hedley-a/MakitaSolarCharger/docs/JBD_BMS_Diagram.pdf

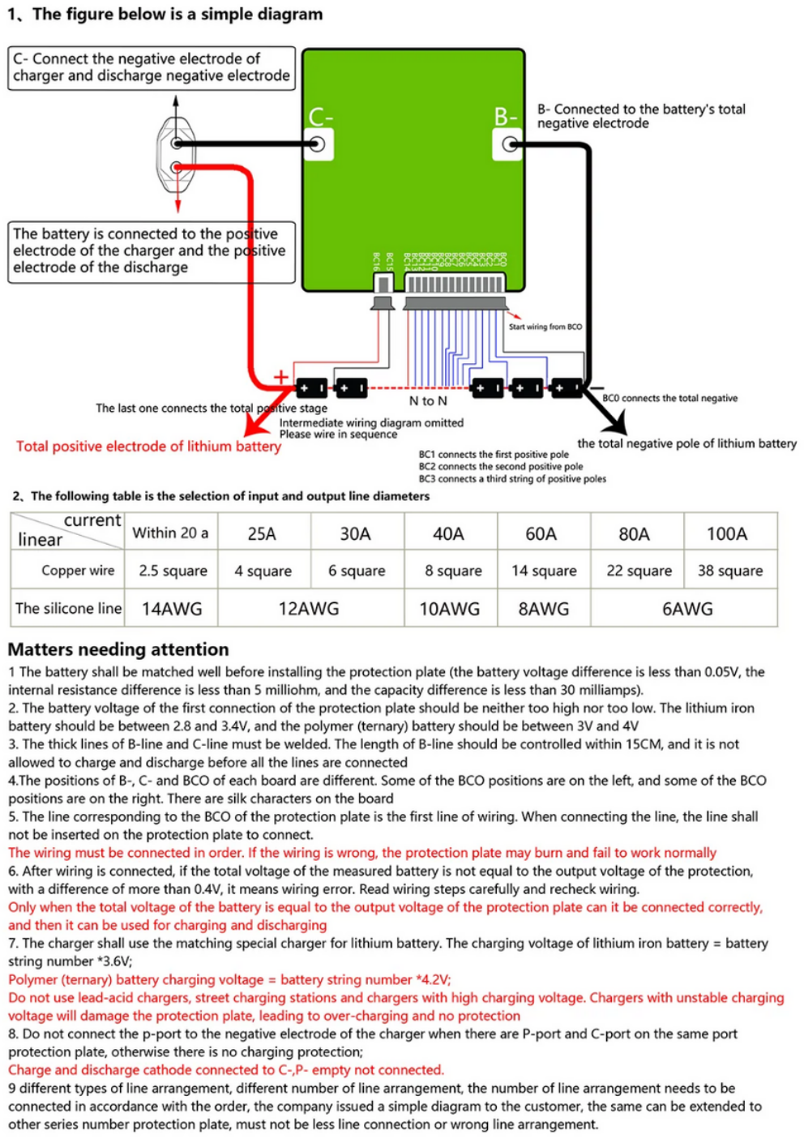
[picture p6: page 1]
