hedley-a/MakitaSolarCharger/docs/Schematic-Mower-Control.pdf

## 485-TTL

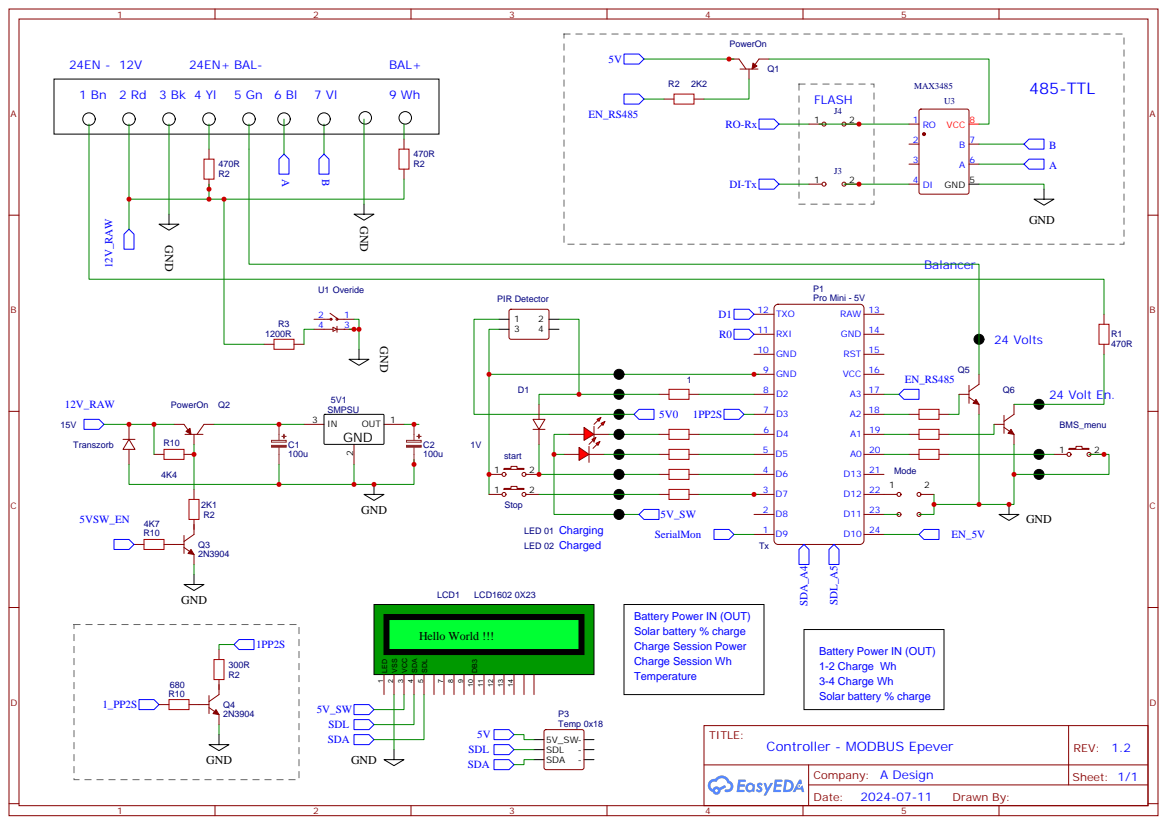
[picture p7: page 1]

Battery Power IN (OUT)
Solar battery % charge
Battery Power IN (OUT) Charge Session Power
Charge Session Wh
Temperature

## External Battery Enclosure

## Battery

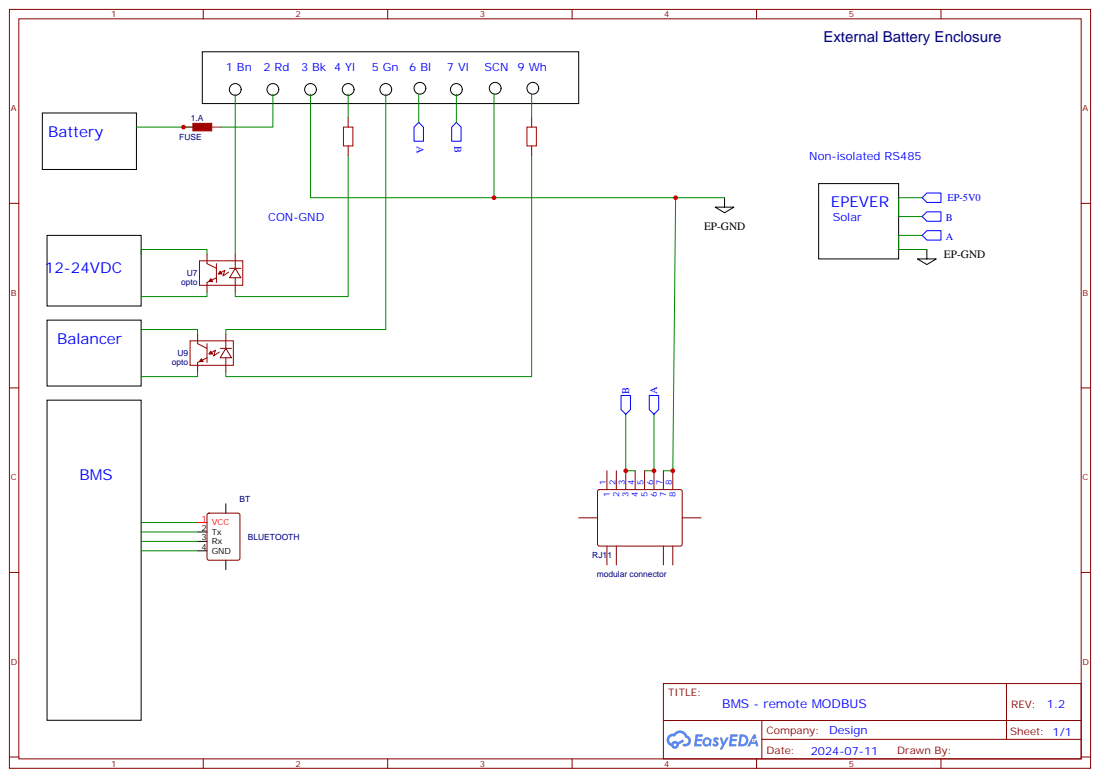
[picture p8: page 2]
