hedley-a/MakitaSolarCharger/docs/StateDiagram.pdf

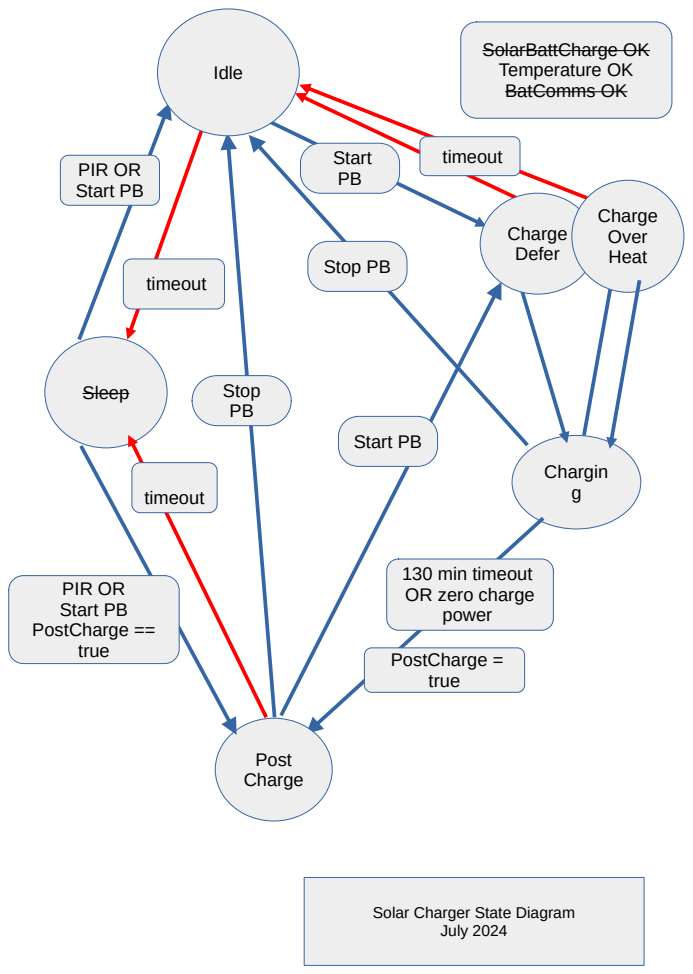
[picture p9: page 1]
Sleep; Chargin g; SolarBattCharge OK; Temperature OK; BatComms OK; July 2024; Post; Charge; Stop; Idle; PIR OR; Start PB; Start; Stop PB; PostCharge =; true; timeout; PostCharge ==; Defer; Over; Heat

130 min timeout
OR zero charge
power

Solar Charger State Diagram

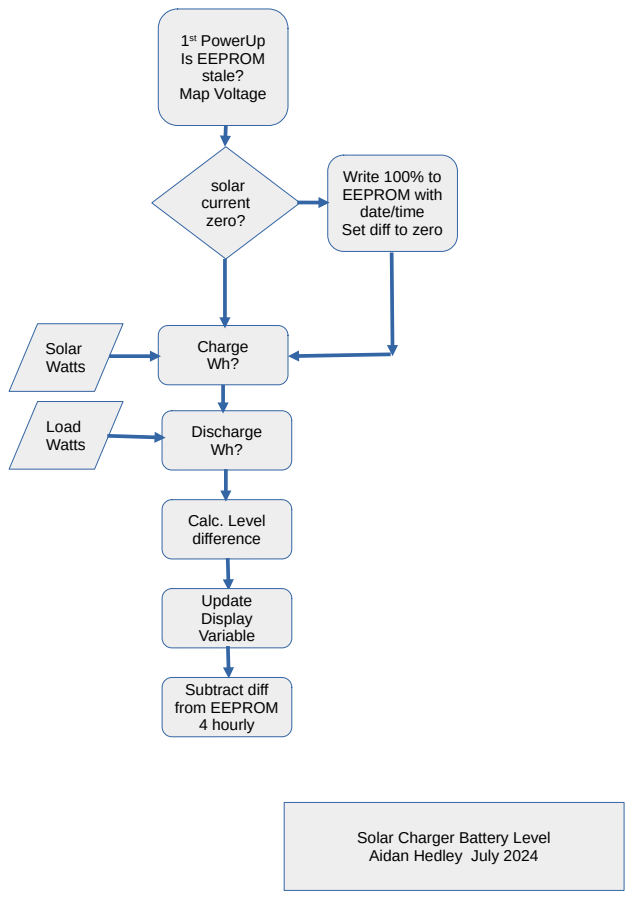
[picture p10: page 2]
solar; current; zero?; Charge; Discharge; Calc. Level; difference; Subtract diff; from EEPROM; 4 hourly; st PowerUp; Is EEPROM; stale?; Map Voltage; Solar; Watts; Load; Update; Display; Variable

Write 100% to
EEPROM with
date/time
Set diff to zero

Solar Charger Battery Level
Aidan Hedley July 2024
