hedley-a/MakitaSolarCharger/docs/ChargerPlan120124.pdf

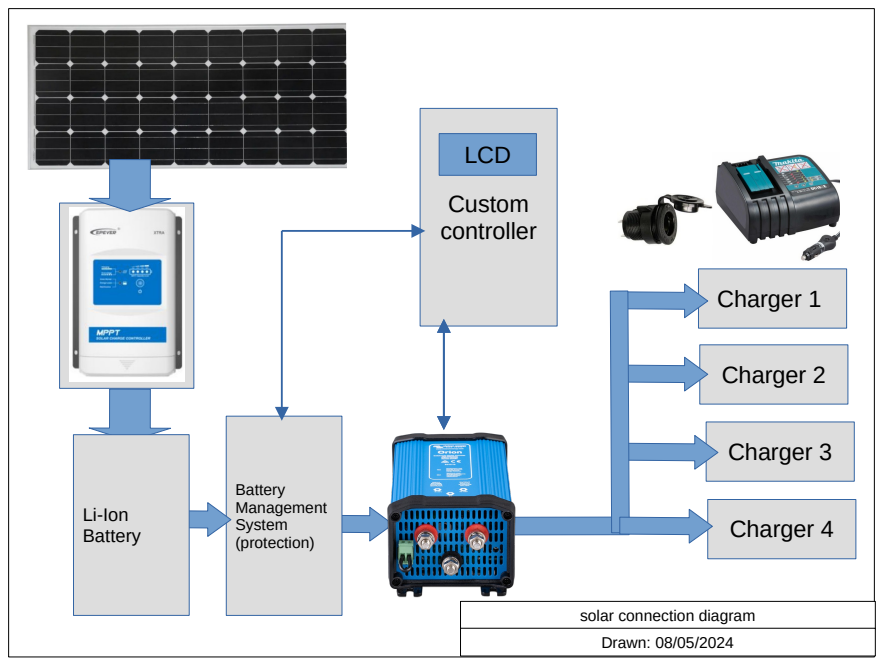
[picture p11: page 1]
Drawn: 08/05/2024; Charger 2; Custom; controller; Charger 1; Charger 3; Charger 4; Battery; Management; System; (protection); Li-Ion; LCD

solar connection diagram
