hedley-a/MakitaSolarCharger/(list of files, drawings)

Other design files:
SCH_Lanchester-Mower_2024-05-06 (1).json
