hedley-a/MakitaSolarCharger/(commit log)

2024-05-05 Add files via upload
    Tested code - reads BMS via TTL serial
2024-05-06 Add files via upload
    updated drawings
    [SCH_Lanchester-Mower_2024-05-06 (1).json]
